theres/boneIO/.resources/board_view.jpg

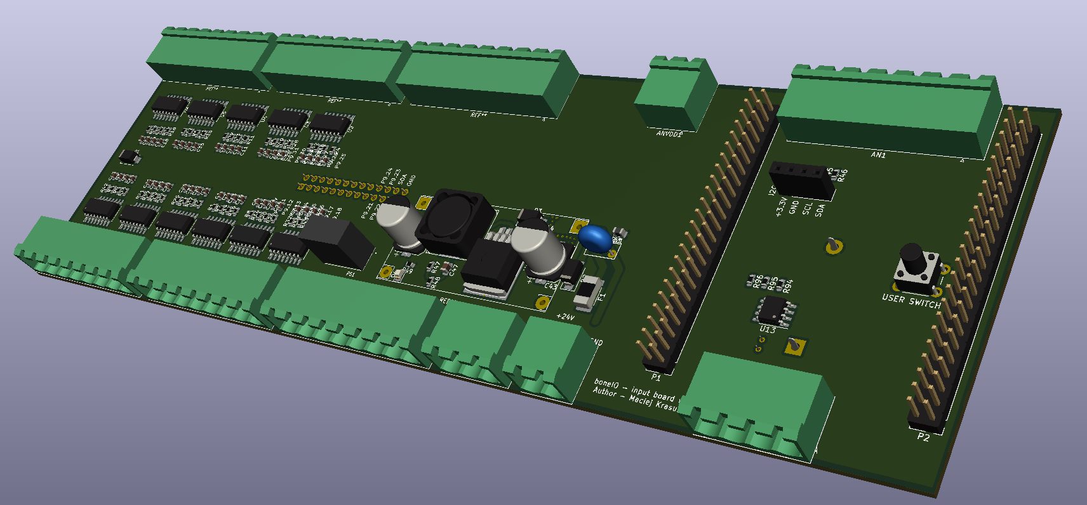
.resources/board_view.jpg
