theres/boneIO/.resources/boneio.jpg

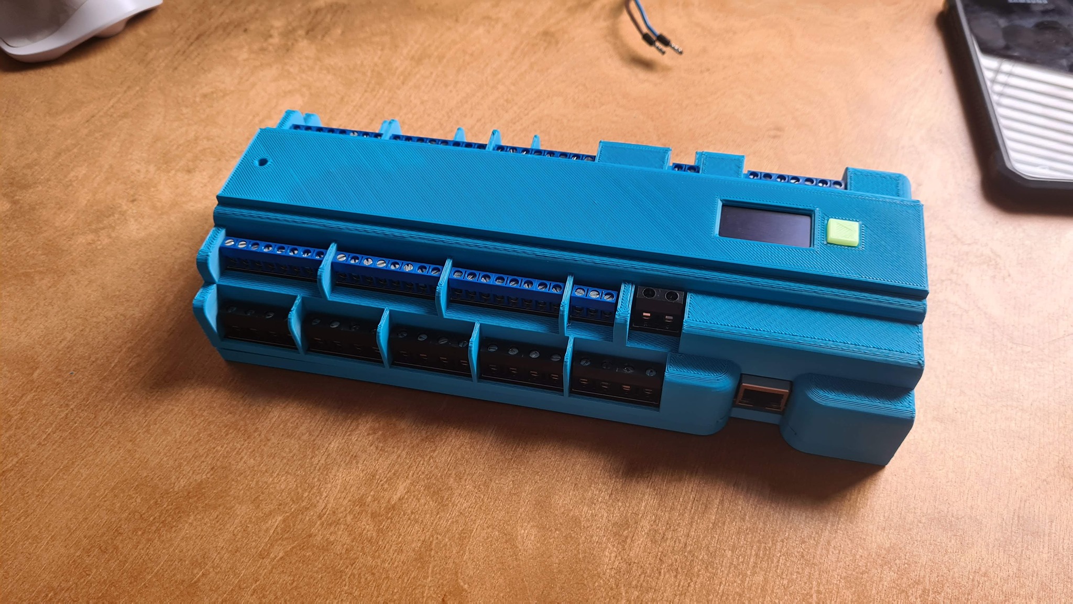
.resources/boneio.jpg
