theres/boneIO/.resources/fork_clone.png

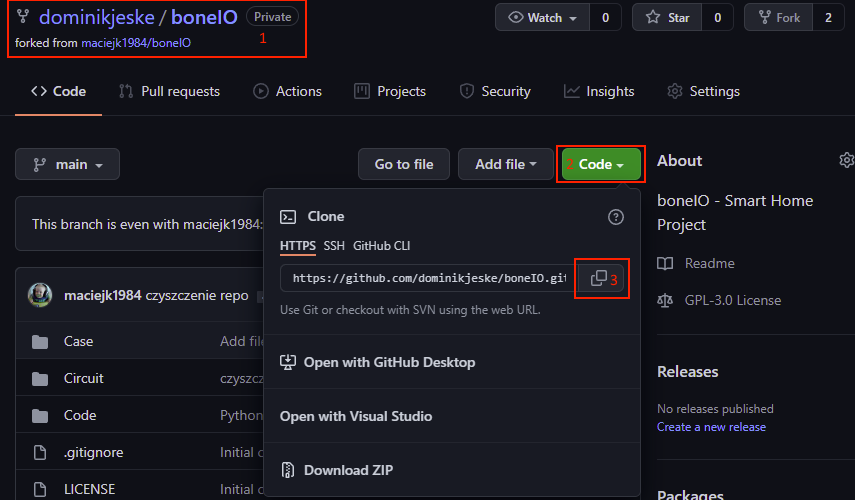
.resources/fork_clone.png
