theres/boneIO/Case/boneIO-case-clips.stp

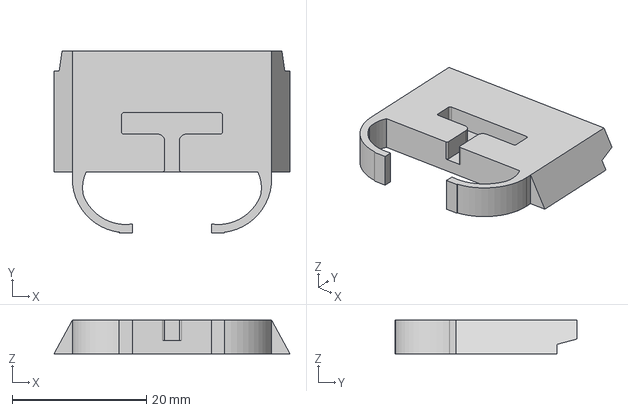
[picture p24: CAD file, 2021-11-11]
Case/boneIO-case-clips.stp
35.2 x 27.1 x 5.00 mm
