theres/boneIO/Case/boneIO-case-blocker.stp

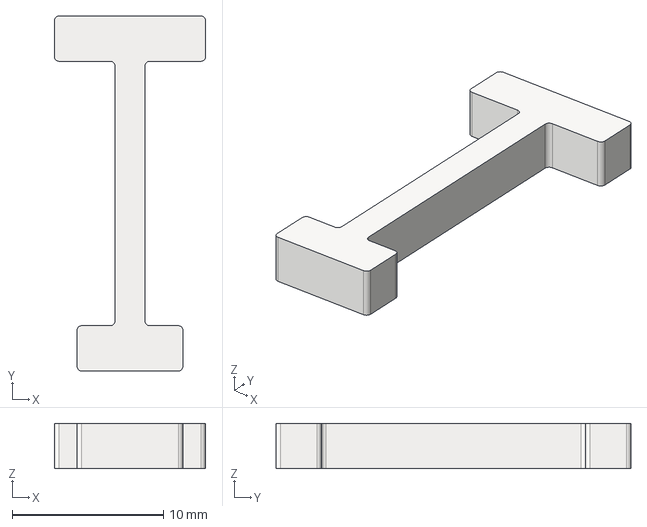
[picture p25: CAD file, 2021-11-11]
Case/boneIO-case-blocker.stp
10.0 x 23.5 x 3.00 mm
