theres/boneIO/Case/boneIO-case-buttont.stp

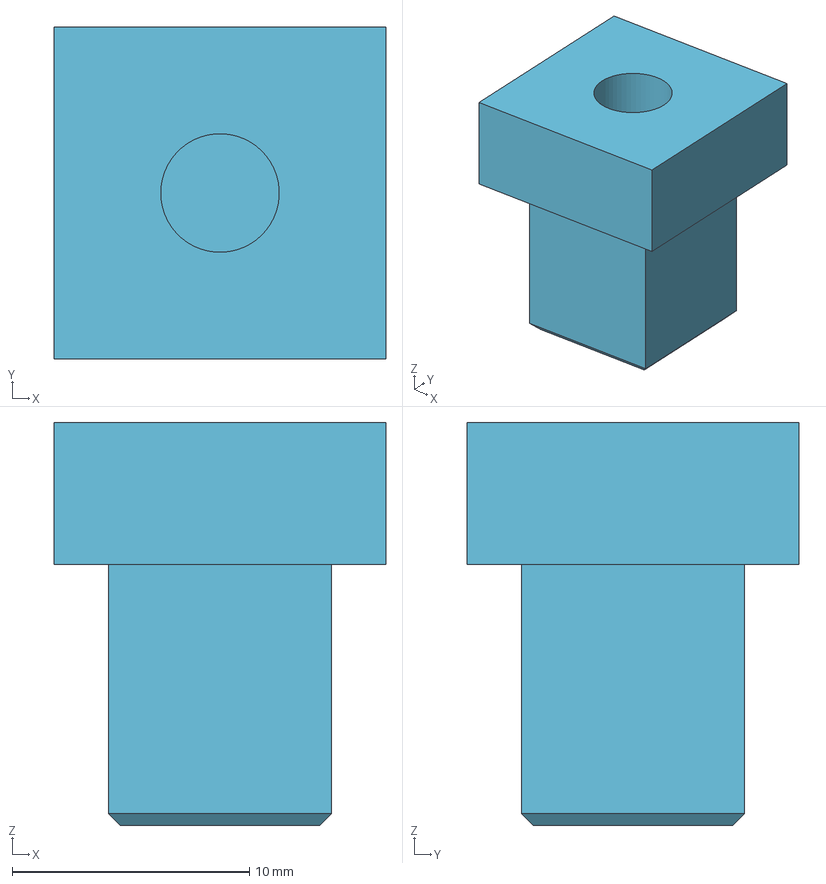
[picture p26: CAD file, 2021-11-11]
Case/boneIO-case-buttont.stp
14.0 x 14.0 x 17.0 mm
