theres/boneIO/Case/boneIO-case-front.stp

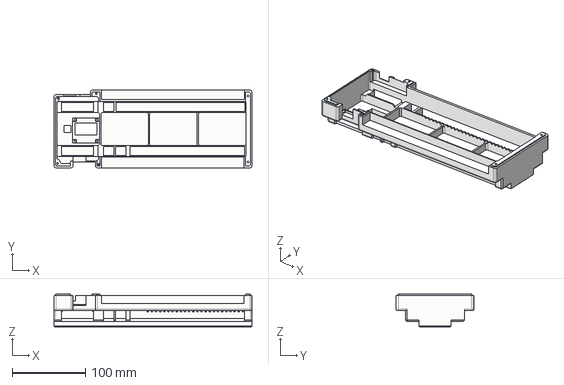
[picture p27: CAD file, 2021-11-11]
Case/boneIO-case-front.stp
270.0 x 106.0 x 44.5 mm
