theres/boneIO/Case/boneIO-case-back.stp

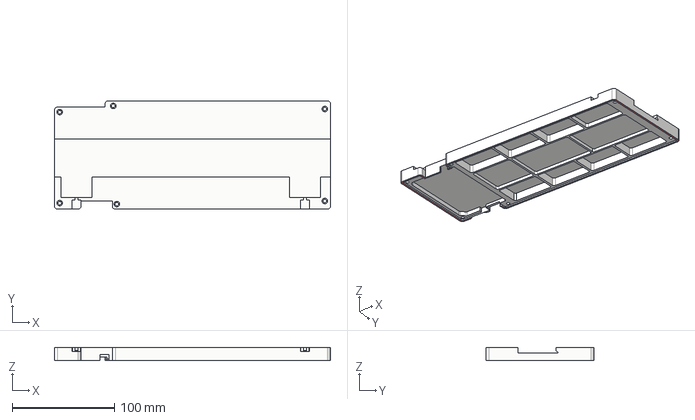
[picture p28: CAD file, 2021-11-11]
Case/boneIO-case-back.stp
270.0 x 106.0 x 12.5 mm
