theres/boneIO/(commit log)

2021-10-12 input board init
    [boneIO - input board-B_Cu.gbr, boneIO - input board-B_Mask.gbr, boneIO - input board-B_SilkS.gbr, boneIO - input board-Edge_Cuts.gbr, boneIO - input board-F_Cu.gbr, boneIO - input board-F_Mask.gbr, boneIO - input board-F_SilkS.gbr, boneIO - input board-NPTH.drl]
2021-10-12 relay board init
    [EDI2CAP.CFG, RM85-2011-35-1005.stl, RM85-2011-35-1005.stp, boneIO - relay board rev0.1.kicad_pcb, boneIO - relay board rev0.1.step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]
2021-10-14 Zmiana gniazd, driverów i dodanie czujnika temp
    [boneIO - relay board.kicad_pcb, boneIO - relay board.sch]
2021-10-16 Zmniejszone pcb
    [RM85-2011-35-1005.stp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]
2021-10-16 czyszczenie repo
    [EDI2CAP.CFG, RM85-2011-35-1005.stl, RM85-2011-35-1005.stp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]
2021-10-17 Circuit Repo Cleanup
    [RM85-2011-35-1005.stp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]
2021-10-23 Update README.md
    Add device description
2021-10-24 Add board view
2021-10-24 Repo Sync for new people
    [boneIO - input board..kicad_pcb, boneIO - input board.sch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]
2021-10-24 KiCad Temp files added to .gitignore
2021-10-24 KiCad Temp files added to .gitignore + KiCad Temp files deleted
2021-10-25 Update boneIO_input board_v0.2.sch
    aktualizacja pcb
    [boneIO_input board_v0.2.sch]
2021-10-25 Zmiany TEST
    TEST
    [boneIO_input board_v0.2.kicad_pcb, boneIO_input board_v0.2.sch]
2021-10-26 Zmiany 27-10-2021
    nowa PCB
    [B2424S-1WR2.step, boneIO_input board_v0.2.kicad_pcb, boneIO_input board_v0.2.sch]
2021-10-27 Aktualizacja 28_10_2021
    [boneIO_input board_v0.2.kicad_pcb, boneIO_input board_v0.2.sch]
2021-10-28 SSR Board Init
    [boneIO - ssr board.kicad_pcb]
2021-10-28 Added pro,net,sch files
    [boneIO - ssr board.sch]
2021-10-28 Finished schema for SSR board
    [boneIO - ssr board.sch]
2021-10-28 Zmiany 28.10.2021_2
    [boneIO_input board_v0.2.kicad_pcb, boneIO_input board_v0.2.sch]
2021-10-28 Schema updates
    - removed pull down resistors between mcp and uln
    - added numbers for resistors and capacitors
    [boneIO - ssr board.sch]
2021-10-29 Input Board_v0.2_F
    PCB ukończone do sprawdzenia.
    [boneIO_input board_v0.2.kicad_pcb, boneIO_input board_v0.2.sch]
2021-10-30 Finished
    Niestety przekombinowaliśmy z tymi ssr'ami i wyszła nam płytka ze zwykłymi przekaźnikami 5A - 30 sztuk. Niestety ssr'y nie zmieściły się na wysokość. Płytka w całości obsługiwana po i2c do zastosowania w module rozszerzeń lub w boneIO bezpośrednio.
    [HF46F.step, boneIO - ssr board.kicad_pcb, boneIO - ssr board.sch]
2021-10-30 Fixed file names
    [HF46F.step, boneIO - relay board 30x5A.kicad_pcb, boneIO - relay board 30x5A.sch]
2021-10-31 j11 changed to support only i2c
    [boneIO - relay board 30x5A.kicad_pcb, boneIO - relay board 30x5A.sch]
2021-11-01 Board resized 2 new form factor, added 2 relays
    [boneIO - relay board 30x5A.kicad_pcb, boneIO - relay board 30x5A.sch]
2021-11-01 Added tracks - almost finished
    [boneIO - relay board 30x5A.kicad_pcb]
2021-11-01 Wykonana PCB RELAY RM85_v0.2
    [boneIO - relay board-B_Cu.gbr, boneIO - relay board-B_Mask.gbr, boneIO - relay board-B_SilkS.gbr, boneIO - relay board-Edge_Cuts.gbr, boneIO - relay board-F_Cu.gbr, boneIO - relay board-F_Mask.gbr, boneIO - relay board-F_SilkS.gbr, boneIO - relay board-NPTH.drl]
2021-11-01 Switched i2c with 3.3 and gnd
    [boneIO - relay board 30x5A.kicad_pcb, boneIO - relay board 30x5A.sch]
2021-11-01 Added input board template
    [boneIO_input board_template.kicad_pcb, boneIO_input board_template.sch]
2021-11-01 Small fixes
    [boneIO - relay board 30x5A.kicad_pcb]
2021-11-02 Fixed missing relay path on front side.
    [boneIO - relay board 30x5A.kicad_pcb]
2021-11-02 Deleted old gerber files
    [boneIO - relay board-B_Cu.gbr, boneIO - relay board-B_Mask.gbr, boneIO - relay board-B_SilkS.gbr, boneIO - relay board-Edge_Cuts.gbr, boneIO - relay board-F_Cu.gbr, boneIO - relay board-F_Mask.gbr, boneIO - relay board-F_SilkS.gbr, boneIO - relay board-NPTH.drl]
2021-11-02 Wersja z dnia 02.11.2021
    [boneIO - relay board-B_Cu.gbr, boneIO - relay board-B_Mask.gbr, boneIO - relay board-B_SilkS.gbr, boneIO - relay board-Edge_Cuts.gbr, boneIO - relay board-F_Cu.gbr, boneIO - relay board-F_Mask.gbr, boneIO - relay board-F_SilkS.gbr, boneIO - relay board-NPTH.drl]
2021-11-02 Moved i2c pullup resistors to the center of the board
    [boneIO - relay board 30x5A.kicad_pcb, boneIO - relay board 30x5A.sch]
2021-11-02 Gotowa PCB board relay v0.2
    [boneIO - relay board.kicad_pcb, boneIO - relay board.sch, boneIOs- input board esp.sch]
2021-11-02 Usunięcie Gerberów
    [boneIO - relay board-B_Cu.gbr, boneIO - relay board-B_Mask.gbr, boneIO - relay board-B_SilkS.gbr, boneIO - relay board-Edge_Cuts.gbr, boneIO - relay board-F_Cu.gbr, boneIO - relay board-F_Mask.gbr, boneIO - relay board-F_SilkS.gbr, boneIO - relay board-NPTH.drl]
2021-11-02 Update boneIO - relay board.kicad_pcb
    [boneIO - relay board.kicad_pcb]
2021-11-02 Fixed board label
    [boneIO - relay board 30x5A.kicad_pcb]
2021-11-02 Wersja Poprawiona
    [boneIO - relay board.kicad_pcb, boneIO - relay board.sch]
2021-11-03 Zmiana Nazwy PCB
    [boneIO - relay board.kicad_pcb, boneIO - relay board.sch]
2021-11-03 Changed directory name for 24x16A
    [EDI2CAP.CFG, RM85-2011-35-1005.stl, RM85-2011-35-1005.stp, boneIO - relay board.kicad_pcb, boneIO - relay board.sch, chips.prt, rm852011351005.psm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]
2021-11-03 Fixed 2, 3, 4, 5
    [boneIO - relay board 30x5A.kicad_pcb]
2021-11-03 Fixed solder mask on back side and couple of other small fixes
    [PH80DS-21.stp, boneIO - relay board 30x5A.kicad_pcb, boneIO - relay board 30x5A.sch]
2021-11-03 Numbering reorder
    [boneIO - relay board 30x5A.kicad_pcb, boneIO - relay board 30x5A.sch]
2021-11-03 Added missing boneIO logo
    [boneIO - relay board 30x5A.kicad_pcb]
2021-11-04 Poprawki Kamil
    [boneIO - relay board 30x5A.kicad_pcb]
2021-11-05 Renamed files to 32x5A
    [HF46F.step, PH80DS-21.stp, boneIO - relay board 32x5A.kicad_pcb, boneIO - relay board 32x5A.sch]
2021-11-05 Update boneIO_input board_v0.2.kicad_pcb
    zmiany 05/11
    [boneIO_input board_v0.2.kicad_pcb]
2021-11-07 Fixed some DRC bugs on schema, and changed directory name to 24x16A
    [EDI2CAP.CFG, RM85-2011-35-1005.stl, RM85-2011-35-1005.stp, boneIO - relay board.kicad_pcb, boneIO - relay board.sch, chips.prt, rm852011351005.psm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]
2021-11-07 DRC Cleanup and some other small fixes
    [PH80DS-21.stp, boneIO - relay board.kicad_pcb, boneIO - relay board.sch]
2021-11-07 Some more small fixes
    [boneIO - relay board.kicad_pcb]
2021-11-08 final PCB version
    [boneIO - relay board.kicad_pcb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]
2021-11-08 PCB design work
    [boneIO_input board_v0.2.kicad_pcb, boneIO_input board_v0.2.sch, boneIO_input board_v0.3.kicad_pcb, boneIO_input board_v0.3.sch]
2021-11-08 update PCB
    [boneIO_input board_v0.3.kicad_pcb, boneIO_input board_v0.3.sch]
2021-11-08 update PCB 08/11/21
    [boneIO_input board_v0.3.kicad_pcb, boneIO_input board_v0.3.sch]
2021-11-08 PCB board to be checked
    [boneIO_input board_v0.3.kicad_pcb, boneIO_input board_v0.3.sch]
2021-11-09 update
    zmiany w rozmieszczeniu BBB i dodane Gerbery, BOM i P&P
    [boneIO_input board_v0.3-B_Cu.gbr, boneIO_input board_v0.3-B_Mask.gbr, boneIO_input board_v0.3-B_Paste.gbr, boneIO_input board_v0.3-B_SilkS.gbr, boneIO_input board_v0.3-Edge_Cuts.gbr, boneIO_input board_v0.3-F_Cu.gbr, boneIO_input board_v0.3-F_Mask.gbr, boneIO_input board_v0.3-F_Paste.gbr]
2021-11-09 Pliki .step obudowy
    [boneIO-case-back.stp, boneIO-case-front.stp]
2021-11-10 Added some kicad files to gitignore
2021-11-10 relay 32x5 directory cleanup
    added shared library with footprints
    [boneIO - relay board 32x5A.kicad_pcb, boneIO - relay board 32x5A.sch]
2021-11-10 cleanup relay board 24x16
    [boneIO - relay board.kicad_pcb, boneIO - relay board.sch]
2021-11-10 Changed board labels
    [boneIO - relay board 32x5A.kicad_pcb, boneIO - relay board.kicad_pcb]
2021-11-10 Wymiana gniazda
    [EDI2CAP.CFG, RM85-2011-35-1005.stl, RM85-2011-35-1005.stp, boneIO - relay board.kicad_pcb, boneIO - relay board.sch, boneIO_input board_template.kicad_pcb, boneIO_input board_template.sch, boneIO_input board_v0.3.kicad_pcb]
2021-11-10 renaming and cleaning files
    [boneIO_input board.kicad_pcb, boneIO_input board.sch]
2021-11-10 fixed PCB errors and added descriptions on the schematic
    [boneIO_input board.kicad_pcb, boneIO_input board.sch]
2021-11-10 corrected inscriptions on jumpers
    [boneIO_input board.kicad_pcb]
2021-11-10 cleanup to finish 0.2
    [boneIO_input board.kicad_pcb, boneIO_input board.sch]
2021-11-10 more cleanup ;)
    [boneIO - SSR D0 board.kicad_pcb, boneIO - SSR D0 board.sch, boneIO - expansion module.kicad_pcb, boneIO - expansion module.sch, boneIOs- input board esp.kicad_pcb, boneIOs- input board esp.sch]
2021-11-10 Dodano przycisk, klips z blokadą
    [boneIO-case-blocker.stp, boneIO-case-buttont.stp, boneIO-case-clips.stp]
2021-11-10 Input Board deleted unused footprints, changed footprint library to point github
    [B2424S-1WR2.step]
2021-11-11 Added boards photos with descriptions
2021-11-11 Added v0.2 case render
2021-11-14 Renamed logo files, added step model of full case with electronic assembly
